LxttleSplat42U/Holo3D_Base/README.md

# Project Video Showcase
Created by: SP Botes for my 2025 skripsie project
- My full project report can be downloaded and viewed as a PDF under the `Report` folder of this repository

https://github.com/user-attachments/assets/740bef9e-0744-42d1-b641-8f48e9746031

# Useful Links
- Code for the main fan base ESP32 (C6), which hosts the WebSocket server for all of the 3D Holographic fan displays is given in this repository
- Code for the other base and fan clients and can be found at https://github.com/LxttleSplat42U/Holo3D_Base_Client and https://github.com/LxttleSplat42U/Fan_Blade respectively
- For a step-by-step assembly guide, please refer to the `Build.md` file
- For steps on how to install the standalone mobile companion application, please refer to the following repositories `README.md` file at https://github.com/LxttleSplat42U/holo3d

# Video Showcase #1: Safety E-Stop
The mobile companion application includes an Emergency Safety Stop, which can be enabled by pressing the "Enable Fan E-Stop" button on the mobile application.

Once enabled, if enough device movement is detected, the fan system will shut down immediately (by sending a "-1" shut-off command to the WebSocket server), after which the fan system can be re-enabled by pressing the "Restart Fan System" button to send the "RESTART" command.

## Safety E-Stop Distant

https://github.com/user-attachments/assets/e4aefa24-4d65-431b-95dd-5887364afc17

## Safety E-Stop Close
Here the safety E-Stop shows the speed at which the shut-down occurs, which will help prevent accidental injury if someone accidentally falls or trips towards the fans.

A small snippet at the beginning also shows how the interactive custom circle image updates in real time as the user interacts with the slider and colour wheel for each fan individually.

https://github.com/user-attachments/assets/bc63d974-ca08-4459-aae9-8a547bc15d5e

# Video Showcase #2: Bluetooth Remote Support
Shows how the bluetooth remote can be used to turn the images on both of the fan displays on/off

https://github.com/user-attachments/assets/6e1bd12c-2f1c-4eac-a2cd-c213a5c6bc58

# Steps on how to use
### Setting up the board
Arduino preferences board manager URL: https://espressif.github.io/arduino-esp32/package_esp32_index.json

### Tools Settings
  Enable CDC on boot (enables flashing without needing to press the physical boot button)
### Libraries used
AsyncTCP by ESP32Async 3.4.9

ESPAsyncWebServer by ESP32Async 3.8.1

# Default configurations used (can be changed if needed, please see the final heading)
## Hardware
Hardware configuration Final_page

## Software
Creates a open WiFi access point "Holo3D" with a WebSockets server accessible at 192.168.4.1 on port 80. (can be changed in "HardwareSoftwareConfig.ino" or "WiFiConfig.h" for more advanced functionality)

# If a different hardware configuration is being used
Edit the "HardwareSoftwareConfig.ino" file and change the pin assignement etc. to match the new hardware configuration.
Ex. If the speed/Hall-effect sensor is connected to a different pin other than pin 1.

This file can also be used to change the WiFi access point name (ssid) and password if needed.

If more configuration is required, such as changing the WebSockets IP address and port/URL. "WiFiConfig.h" can be edited to the new required values.
