LxttleSplat42U/Holo3D_Base/BUILD.md

# Assembly instructions

1. Take the rotating subasssembly



2. Fix the LED clip in place with an M3 fastener




3. Attach one of the fan blades and push the LEDs through




4. Secure the slip ring clip and screw the stationary subassembly onto the tripod stand




5. Attach the rotating fan assembly to the motor shaft using the M3 grub screw and a hex screw driver
