LxttleSplat42U/Holo3D_Base/(commit log)

2025-09-29 Basic LED On/Off
2025-09-30 Basic multi fan Circle or spiral control
2025-10-08 Optimisation and error shutdown on disconnect
    All clients now need to send a "REGISTER:XX" command upon connection to server to allocate a Unique ID per client. This is saved to a map for use.
    Now forwards only commands received from user application to the relevant client instead of to all clients based on the "ID" received in the message.
    This optimised the system to be more responsive.
    Now sends a shutdown command "-1" to all clients if user disconnects.
    [Main_AP_Motor.ino]
2025-10-24 Add assembly instructions to BUILD.md
    Added detailed assembly instructions with images for the rotating fan assembly.
2025-12-10 Update assembly instructions for clarity and accuracy
